roobear777/resilience_ESP/docs/interaction_logic.md

# Interaction Logic

This file describes what the controller does during normal live operation.

## Core Loop

The controller repeatedly:

1. Reads 8 active-HIGH button inputs.
2. Debounces button readings.
3. Detects accepted new press events.
4. Updates FIRE pulse state.
5. Updates Head Poof state.
6. Updates LED trigger windows.
7. Writes active-LOW FIRE outputs.
8. Renders and sends LED data to the Output Expander.
9. Updates OLED, Serial diagnostics, and web server handling.

## Buttons

Buttons use active-HIGH logic:

```text
LOW  = released
HIGH = pressed
```

The live wiring uses external 10k pull-downs. Firmware uses normal input mode for the button pins.

## Normal FIRE Behaviour

Normal button-to-FIRE mapping:

```text
Button 1 -> FIRE1
Button 2 -> FIRE2
Button 3 -> FIRE3
Button 4 -> FIRE4
Button 5 -> FIRE5
Button 6 -> FIRE6
Button 7 -> FIRE7
Button 8 -> FIRE8
```

FIRE outputs are active-LOW:

```text
HIGH = idle / inactive
LOW  = trigger / active
```

Normal FIRE1-FIRE8 pulse duration:

```text
500 ms
```

The normal FIRE pulse is separate from the LED animation duration.

## Normal LED Behaviour

Ambient LED animation starts automatically after boot.

Normal button-to-LED mapping:

```text
Button 1 -> Z1 / Mouth
Button 2 -> Z2 / Shoulder
Button 3 -> Z3 / Midbody
Button 4 -> Z4 / Rear
Button 5 -> Z5 / Front legs
Button 6 -> Z6 / Back legs
Button 7 -> Z7 / Digestive
```

Button 8 alone does not trigger an independent LED zone. It still triggers FIRE8.

Z8 is the button-station LED zone. It mirrors/summarizes Z1-Z7 activity and participates in Full Body LED Animation.

Triggered LED zones use the saved global animation duration. Default:

```text
10 seconds
```

When that duration expires, each zone returns to ambient rendering.

## Head Poof

Button 1 + Button 8 = Head Poof / FIRE9 + Full Body LED Animation.

When the combo is accepted:

```text
Head Poof / FIRE9 triggers
all LED zones Z1-Z8 are active together for the saved global animation duration, then return to ambient
```

Head Poof FIRE output:

```text
FIRE9 active while combo is held, with 10 second maximum cutoff
```

Full Body LED Animation:

```text
all LED zones Z1-Z8 active together for the saved global animation duration
then return to ambient
```

The Full Body LED Animation duration and Head Poof FIRE cutoff are separate settings/behaviours.

## Temporary Proof-of-Concept Interactions

These behaviours are experimental proof-of-concept changes. They may be removed or changed before the final live build, and should not be treated as stable baseline behaviour.

Normal FIRE repeat proof of concept:

```text
first valid button press -> immediate FIRE pulse
held button             -> additional FIRE pulse every 1000 ms
normal FIRE pulse       -> 100 ms
release                 -> stops further repeat pulses
```

All-buttons FIRE proof of concept:

```text
Buttons 1-8 held together -> FIRE1-FIRE9 active together for 500 ms
held after the pulse      -> no repeat
re-arm                    -> release at least one button, then press all eight again
```

While the all-buttons pulse is active, normal repeating FIRE and Head Poof FIRE requests are suppressed.

LED override proof of concept:

```text
Buttons 2 + 6 held together -> all LED zones Z1-Z8 render solid green
release either button       -> normal LED rendering resumes
```

This green LED override is runtime-only. It does not change saved settings, palettes, brightness, saturation, zone configuration, or web controller state.

## Web Controller

The web controller changes LED look/feel settings only.

It does not provide FIRE, relay, or hardware test controls.

Web setting changes apply live in RAM. `SAVE` persists them to flash. `RESET` restores defaults in RAM until saved.

## OLED Model

The OLED controller page prioritizes live controller state:

```text
SIMULATED or LIVE
READY / FIRING / PULSE COMPLETE / HEAD POOF
Input: ...
FIRE: ...
LED: ...
```

The setup page is for LED UART/web setup status and must not claim that physical LEDs or wiring are proven good.

## Safety Boundaries

Do not change these without an explicit safety task:

- FIRE GPIO assignments
- FIRE active-LOW polarity
- normal 500 ms FIRE pulse
- Head Poof 10 second FIRE cutoff
- button mappings
- LED channel mapping
- GPIO39 Output Expander UART setting
