roobear777/resilience_ESP/diagrams/Schematic whole system.jpeg

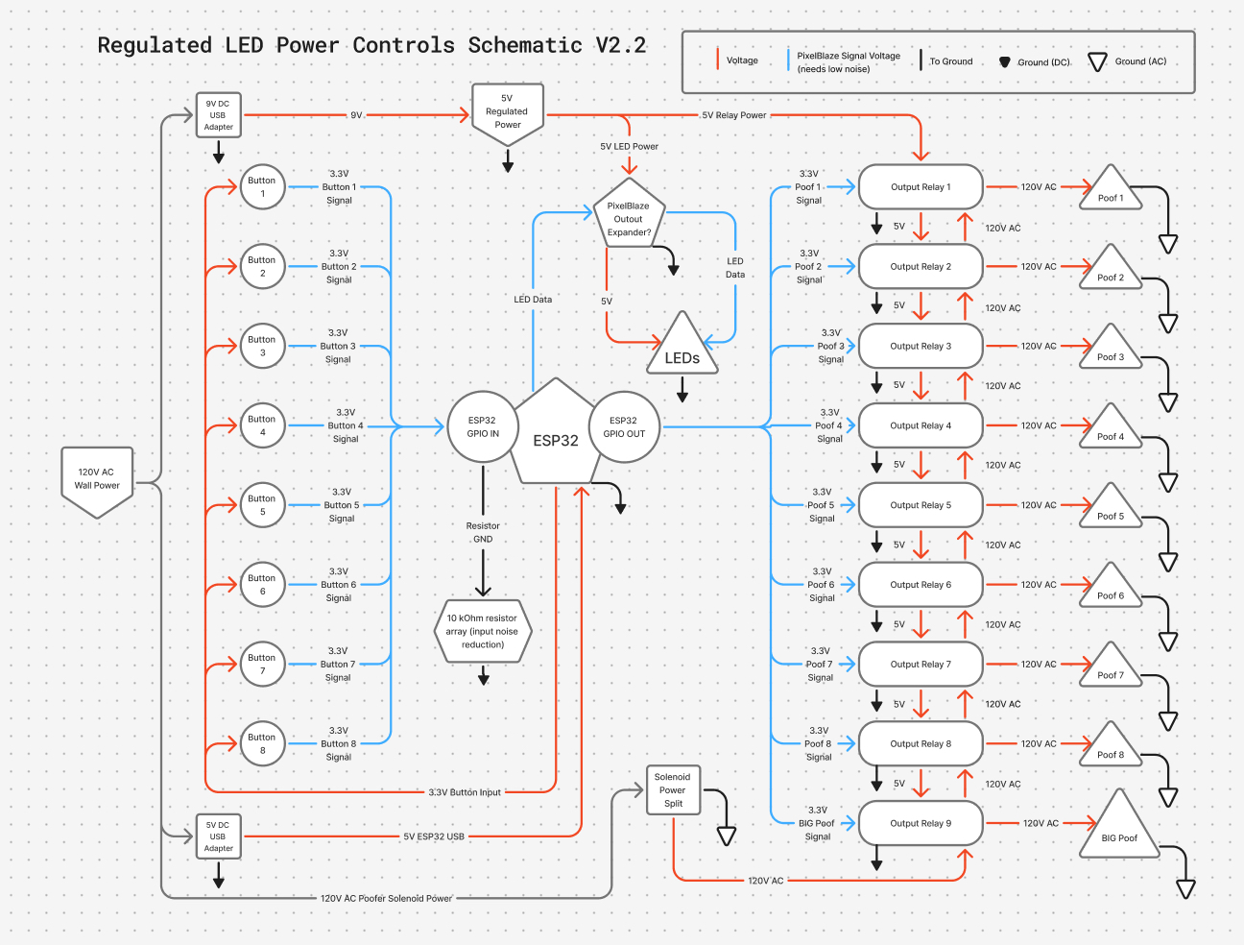
diagrams/Schematic whole system.jpeg
