roobear777/resilience_ESP/digram_final.png

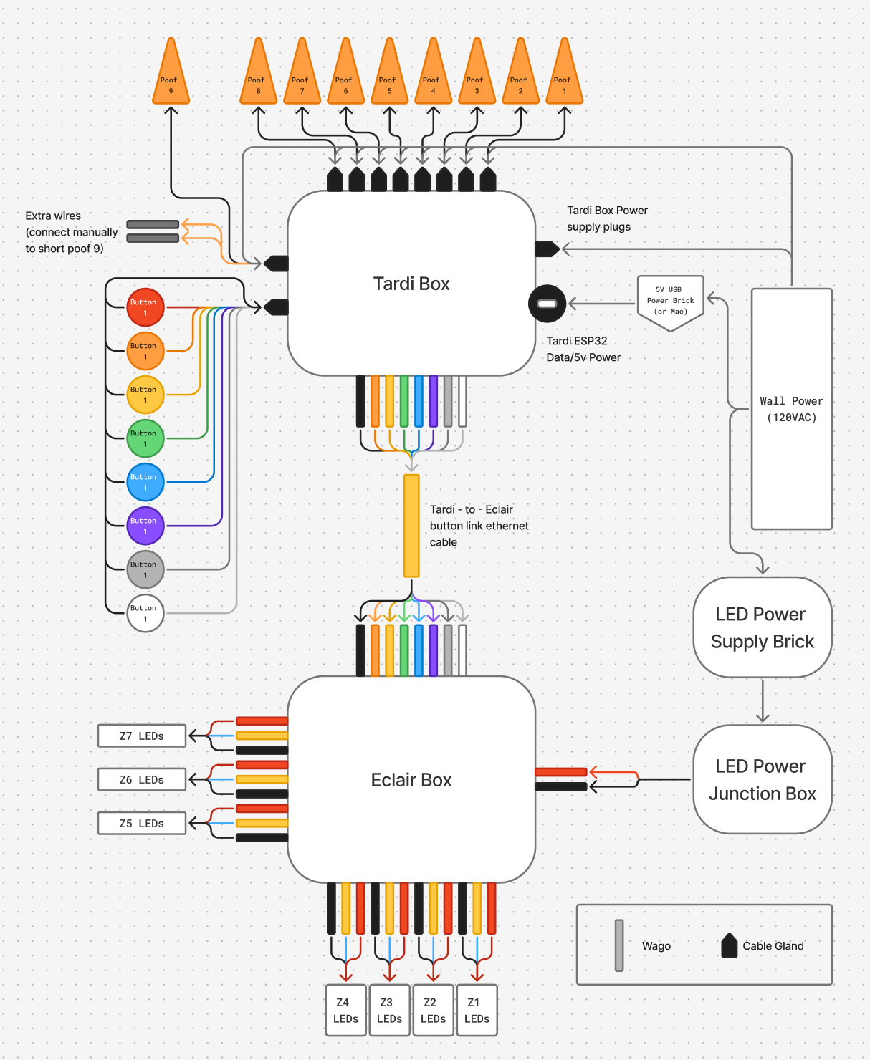
digram_final.png
