roobear777/resilience_ESP/QR wifi.png

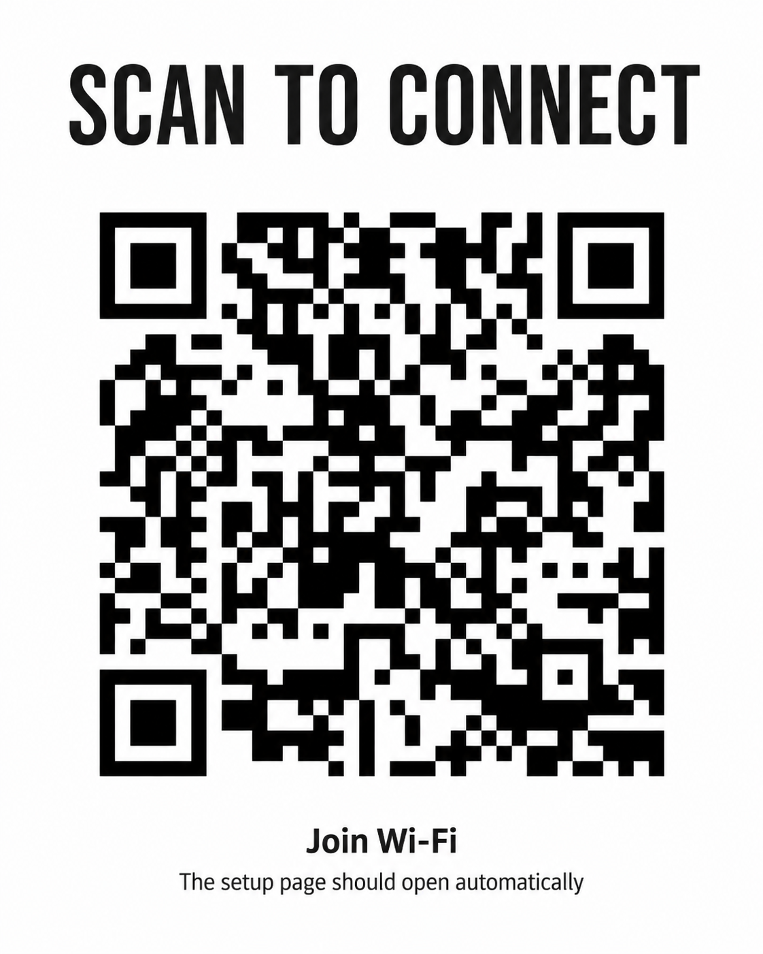
QR wifi.png
