roobear777/resilience_ESP/ESP_wiring_diagram..png

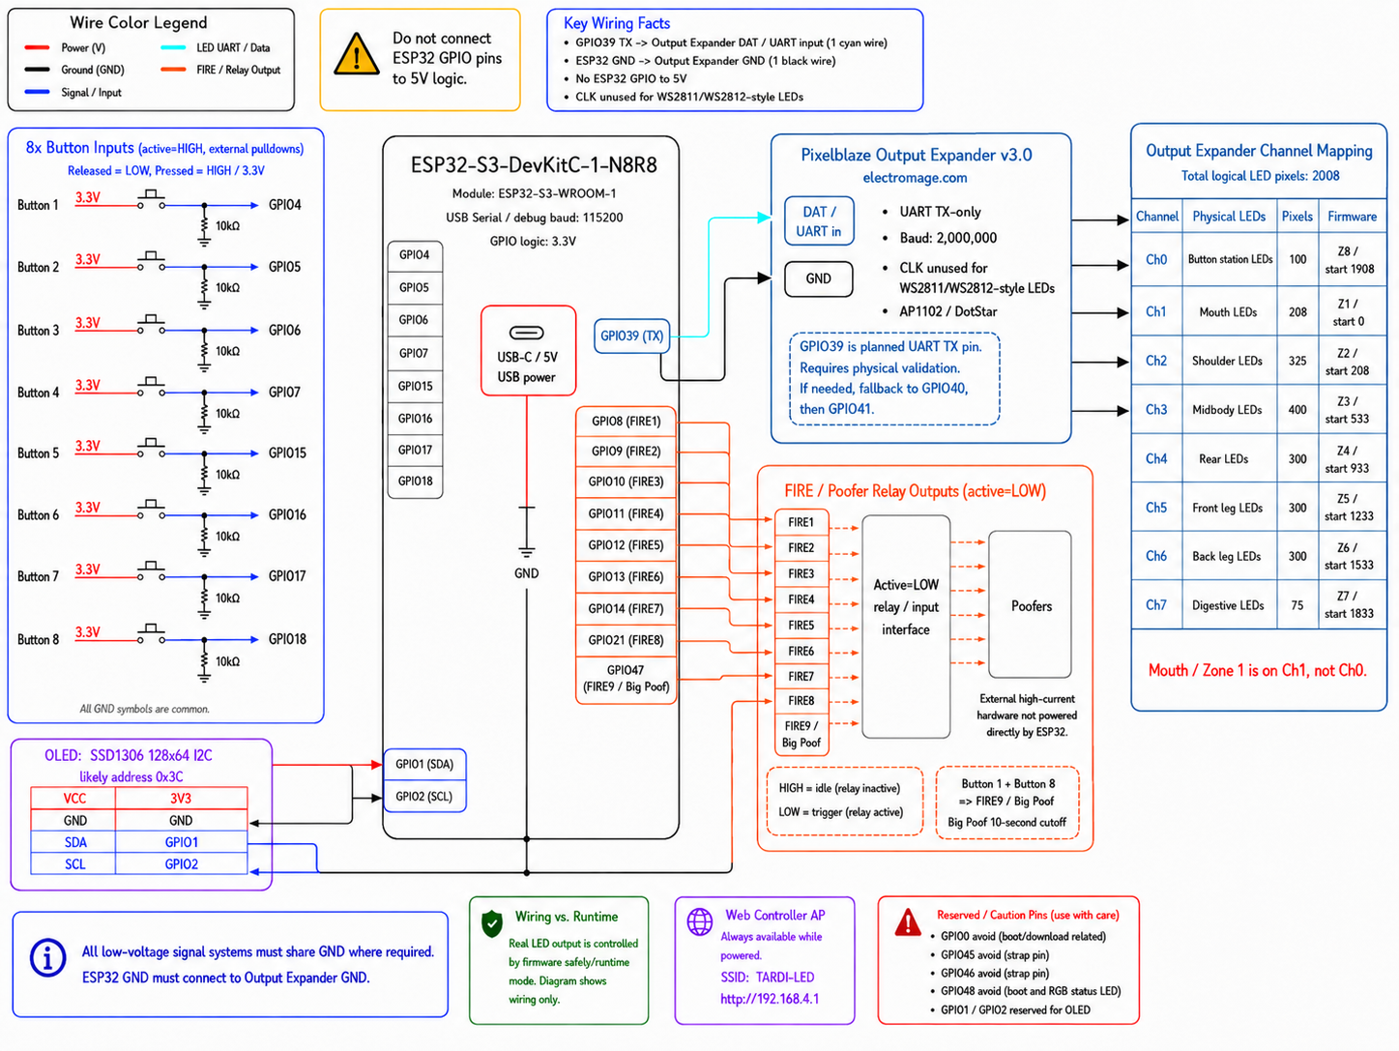
ESP_wiring_diagram..png
