roobear777/resilience_ESP/firmware/esp32_controller/src/main.cpp

// Empty on purpose.
//
// The Arduino IDE currently uses:
// ../esp32_controller.ino
//
// This placeholder exists only because PlatformIO creates src/main.cpp
// by default. Do not add setup() or loop() here while the .ino sketch
// is the active Arduino IDE sketch.
