roobear777/resilience_ESP/(commit log)

2026-06-13 Initial ESP32 controller project
2026-06-15 Prepare California LED validation flow
2026-06-16 wiring diagram
2026-06-23 Led red/green fix and clean up
    [esp32_controller.ino, led_expander_output.cpp]
2026-07-11 Add proof-of-concept combo interactions
    - Repeating 100 ms FIRE pulses every 1000 ms while a button is held
    - New all-buttons combo triggering a single 500 ms pulse on FIRE1–FIRE9
    - New Buttons 2+6 combo enabling a temporary solid green LED override
2026-07-24 Auto-start live LED output during updates
2026-07-28 Add LED colourd
2026-08-20 Combo lighting, fire rework, and flashing docs
    LED (Eclair) - new EclairTardiSplit_Combos, baseline untouched
    -------------------------------------------------------------
    Colour combos driven by how many ZONES ARE LIT, scoped to the held zones.
    Press 2 and 3 and only Z2 and Z3 change colour, together; the rest of the
    sculpture carries on. Station strings follow their own zone.
    Three rounds of fixes against hardware:
    - ORGANIC is now an exact no-op. It had lengthScale 1.35, which stretched
    Z8's chase tail from 5 px to 6.75 px on a 14 px station string and turned
    a crisp chase into a smear BY DEFAULT.
    - ledScaledNowMs multiplied a uint64 by a float, promoting the whole
    expre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
    [Eclair_LED.ino, Tardi_Fire.ino, led_combo.cpp, led_combo.h, led_engine.cpp, led_engine.h, led_legs.cpp]
2026-08-20 Collapse EclairTardiSplit_Combos into EclairTardiSplit
    One flashable folder instead of two. The combo build becomes the only
    Eclair_LED; the old one still had the 30 ms debounce that caused phantom
    triggers and the B2+B6 green override.
    Tardi_Fire and LCD_Driver_Test unchanged. READMEs merged; behaviour table,
    serial command list and the COMBO_HUE tuning snippet corrected.
    [Eclair_LED.ino, Tardi_Fire.ino, led_combo.cpp, led_combo.h, led_engine.cpp, led_engine.h, led_legs.cpp]
